PMinhDuc204/pwm-solar-design/kicad/pwm-2420-lus.kicad_pcb

## KiCad design kicad/pwm-2420-lus.kicad_pcb (2026-11-06)

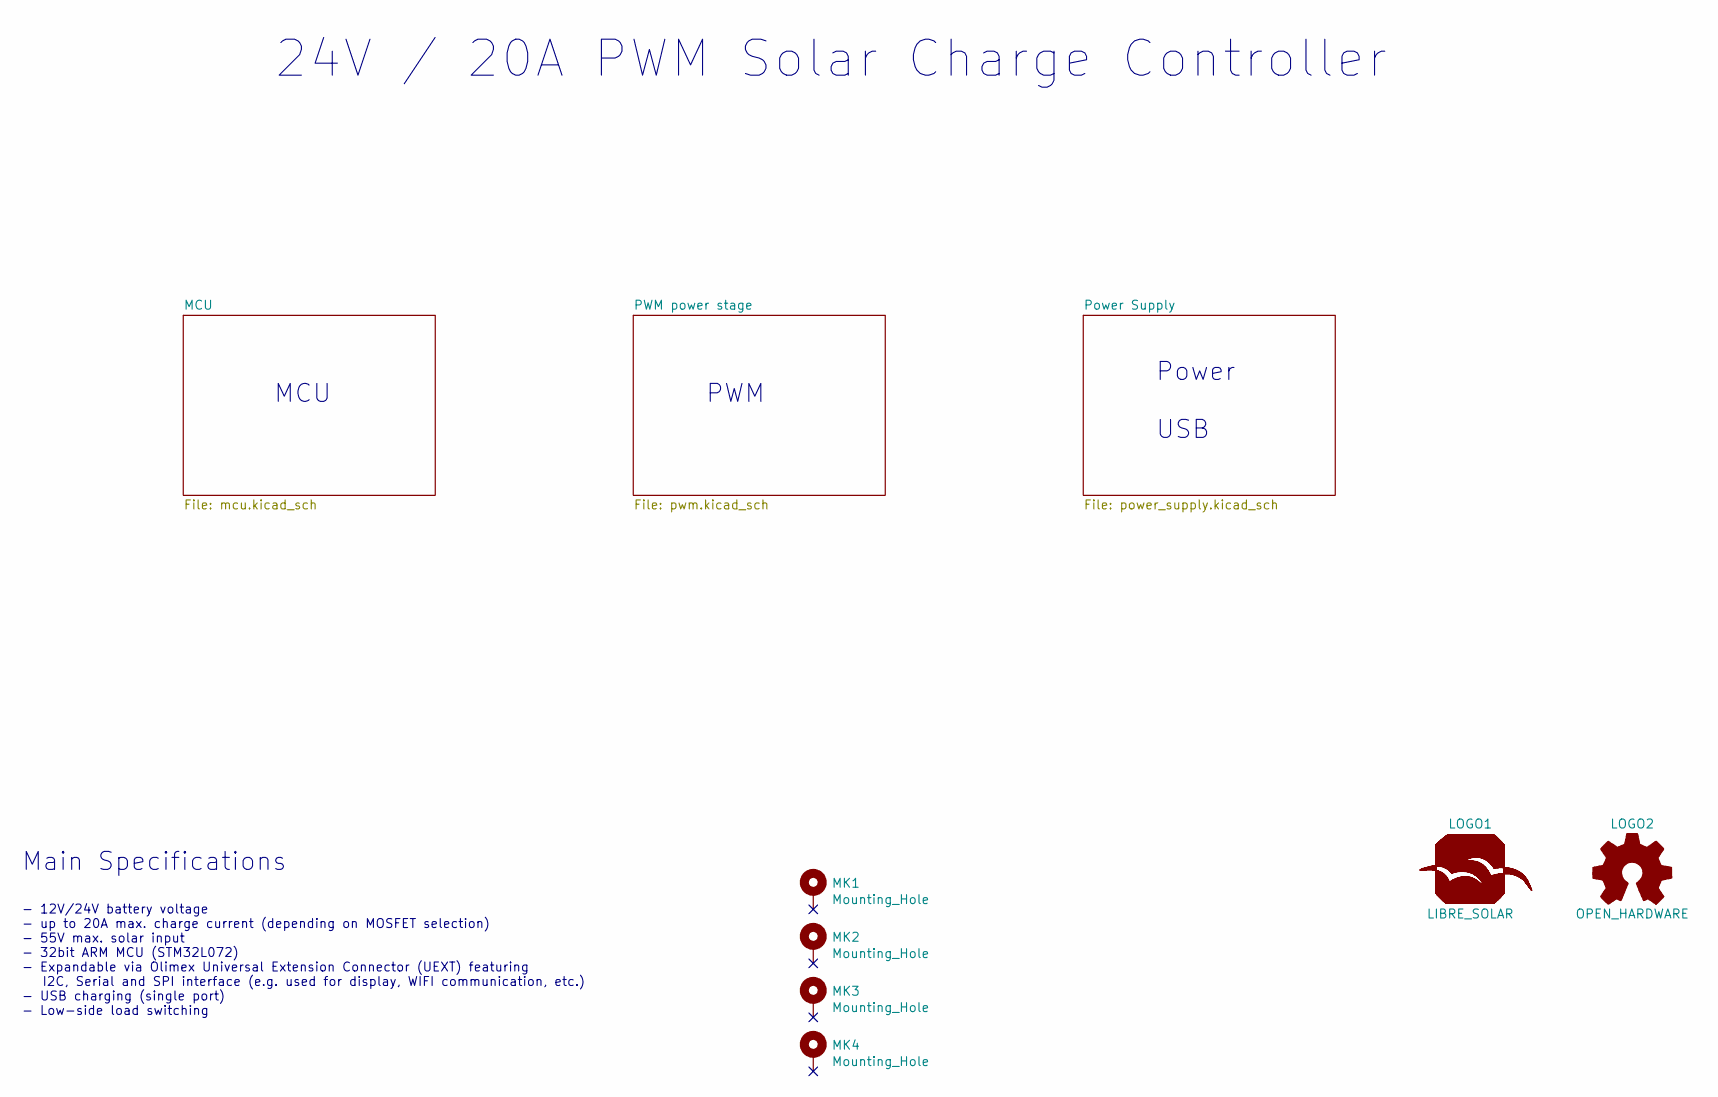
[picture p1: schematic pwm-2420-lus.kicad_sch, PWM 2420 LUS]

Parts:
LOGO1: LIBRE_SOLAR; LIBRESOLAR_LOGO
LOGO2: OPEN_HARDWARE; OSHW-Logo_5.7x6mm_SilkScreen
MK1, MK2, MK3, MK4: Mounting_Hole; MountingHole_3.2mm_M3_Pad

Notes on the sheet:
MCU
Main Specifications
24V / 20A PWM Solar Charge Controller
PWM
- 12V/24V battery voltage - up to 20A max. charge current (depending on MOSFET selection) - 55V max. solar input - 32bit ARM MCU (STM32L072) - Expandable via Olimex Universal Extension Connector (UEXT) featuring I2C, Serial and SPI interface (e.g. used for display, WIFI communication, etc.) - USB c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
Power USB

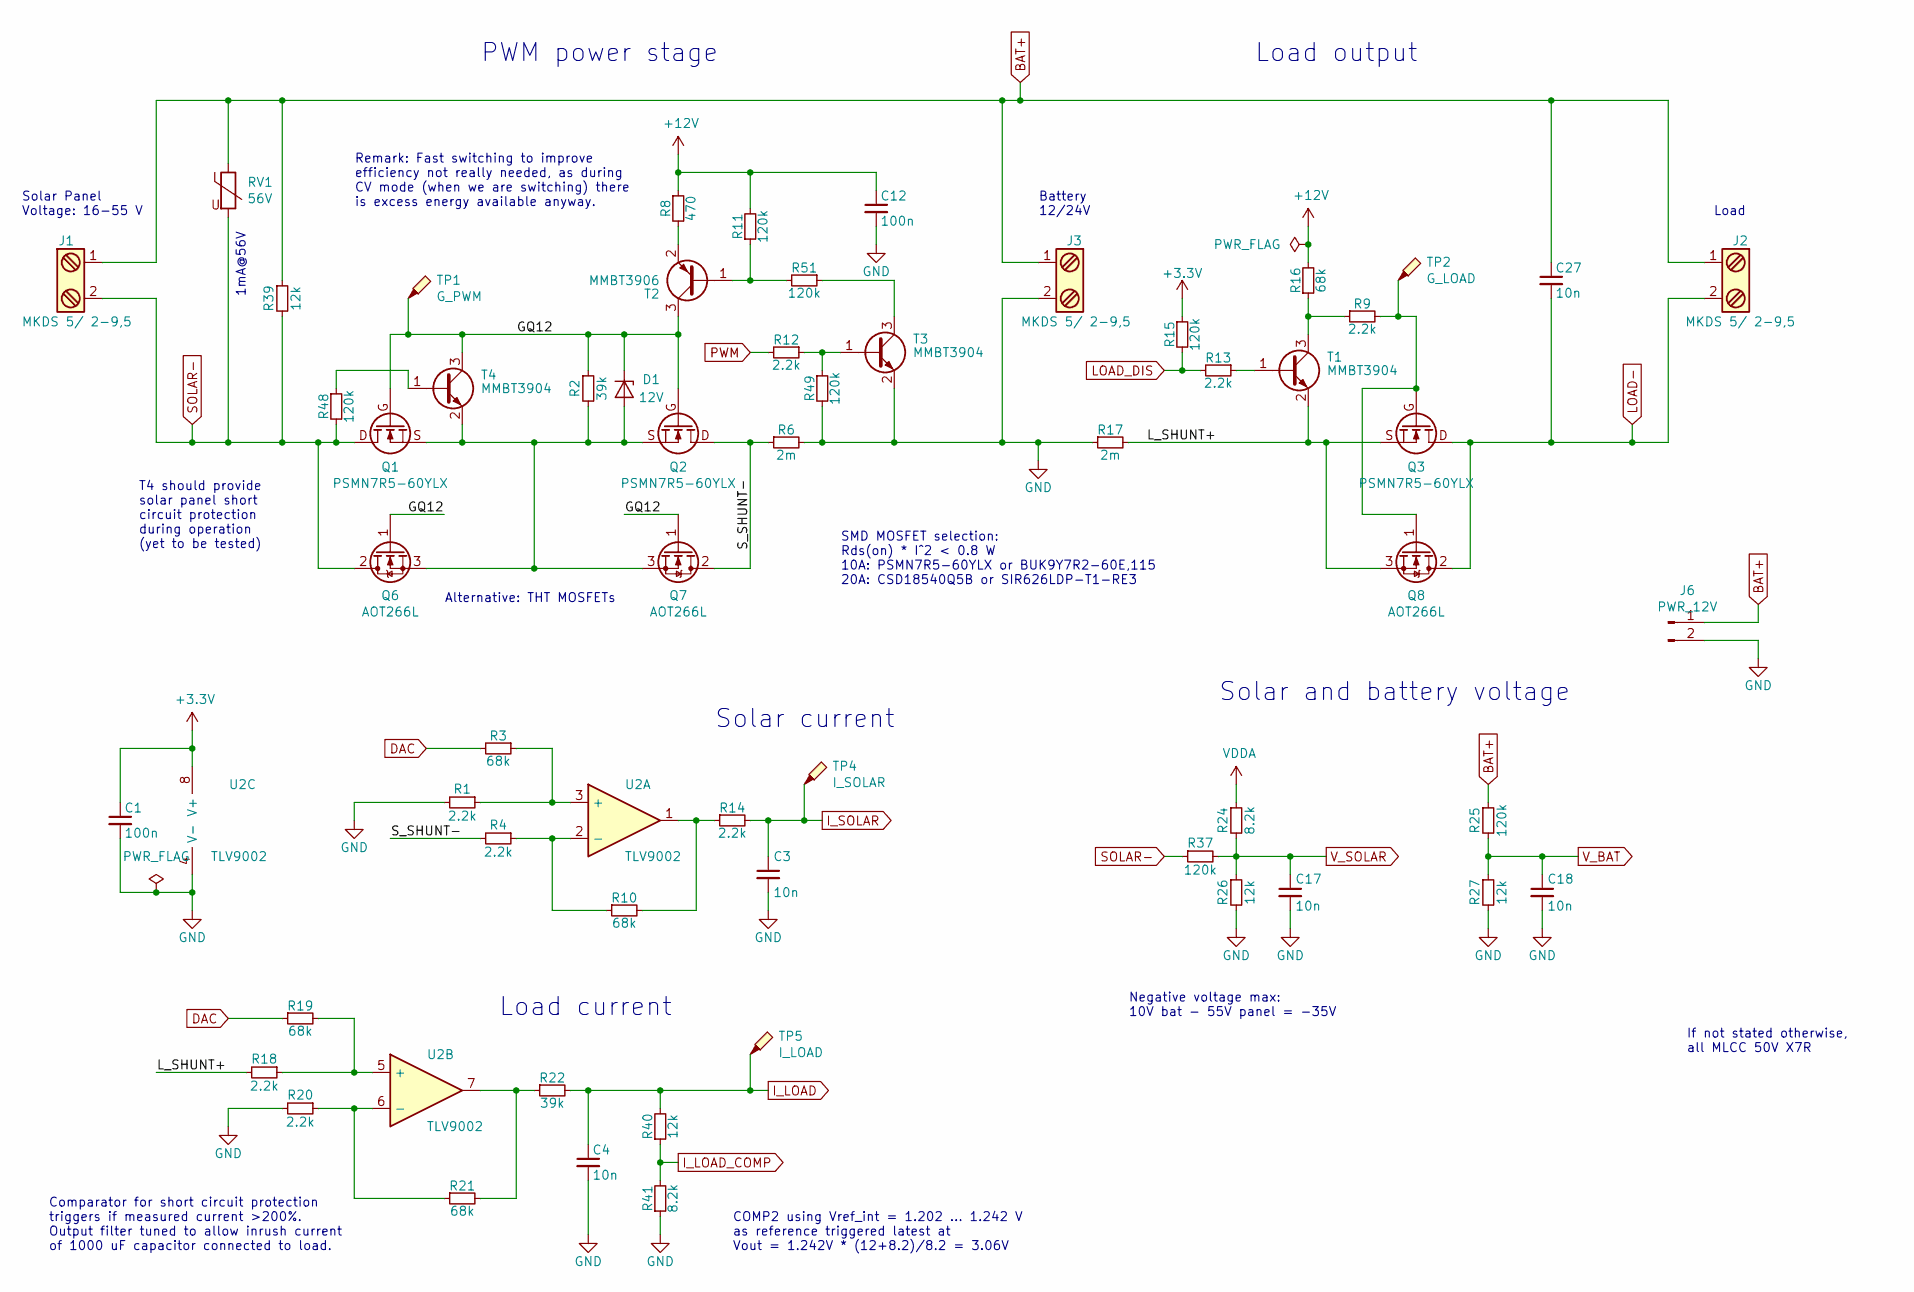
[picture p2: schematic pwm.kicad_sch, PWM 2420 LUS]

Parts:
C1, C12: 100n; C_0805_2012; PartNumber CC0805KRX7R9BB104
C3, C4, C17, C18, C27: 10n; C_0805_2012; PartNumber CC0805KRX7R0BB103
D1: 12V; D_SOT-23_ANK; PartNumber SZBZX84C12LT3G
J1, J2, J3: MKDS 5/ 2-9,5; Phoenix_Contact_MKDS_5-2-952; PartNumber 1714971
J6: PWR_12V; JST_XH_B2B-XH-A_1x02_P2.50mm_Vertical; PartNumber B2B-XH-A (LF)(SN)
Q1, Q2, Q3: PSMN7R5-60YLX; 5X6_MOSFET; PartNumber PSMN7R5-60YLX
Q6, Q7, Q8: AOT266L; TO-220-3_Horizontal_TabUp; PartNumber AOT266L
R1, R4, R9, R12, R13, R14, R18, R20: 2.2k; R_0805_2012; PartNumber RC0805FR-072K2L
R2: 39k; R_0805_2012; PartNumber RC0805FR-0739KL
R3, R10, R16, R19, R21: 68k; R_0805_2012; PartNumber RC0805FR-0768KL
R6, R17: 2m; R_Bourns_CRE2512; PartNumber CRE2512-FZ-R002E-3
R8: 470; R_0805_2012; PartNumber RC0805FR-07470RL
R11, R15, R25, R37, R48, R49, R51: 120k; R_0805_2012; PartNumber RC0805FR-07120KL
R22: 39k; R_0805_2012; PartNumber RC0805FR-0739K0L
R24, R41: 8.2k; R_0805_2012; PartNumber RC0805FR-078K2L
R26, R27, R39, R40: 12k; R_0805_2012; PartNumber RC0805FR-0712KL
RV1: 56V; RV_Disc_D12mm_W4.3mm_P7.5mm; PartNumber MOV-10D560K
T1, T3, T4: MMBT3904; SOT-23; PartNumber MMBT3904-7-F
T2: MMBT3906; SOT-23; PartNumber MMBT3906-7-F
TP1: G_PWM; TestPoint_Pad_D1.0mm
TP2: G_LOAD; TestPoint_Pad_D1.0mm
TP4: I_SOLAR; TestPoint_Pad_D1.0mm
TP5: I_LOAD; TestPoint_Pad_D1.0mm
U2: TLV9002; SOIC-8_3.9x4.9mm_Pitch1.27mm; PartNumber LM258DR

Connections:
+3V3: C1.1, R15.1, U2.8 (V+); also elsewhere on the board
+12V: C12.1, R8.1, R11.2, R16.2; also elsewhere on the board
/PWM power stage/GQ12: D1.1 (K), Q1.G, Q2.G, Q6.1 (G), Q7.1 (G), R2.1, T2.3 (C), T4.3 (C), TP1.1
/PWM power stage/L_SHUNT+: Q3.S, Q8.3 (S), R17.2, R18.2, T1.2 (E)
/PWM power stage/S_SHUNT-: Q2.D, Q7.2 (D), R4.2, R6.1
BAT+: C27.1, J1.1, J2.1, J3.1, J6.1, R25.1, R39.1, RV1.1; also elsewhere on the board
DAC: R3.2, R19.1; also elsewhere on the board
GND: C1.2, C3.2, C4.2, C12.2, C17.2, C18.2, J3.2, J6.2, R1.2, R6.2, R17.1, R20.2, R26.2, R27.2, R41.1, R49.2, T3.2 (E), U2.4 (V-); also elsewhere on the board
I_LOAD: C4.1, R22.2, R40.2, TP5.1; also elsewhere on the board
I_LOAD_COMP: R40.1, R41.2; also elsewhere on the board
I_SOLAR: C3.1, R14.2, TP4.1; also elsewhere on the board
LOAD-: C27.2, J2.2, Q3.D, Q8.2 (D); also elsewhere on the board
LOAD_DIS: R13.2, R15.2; also elsewhere on the board
unnamed: D1.2 (A), Q1.S, Q2.S, Q6.3 (S), Q7.3 (S), R2.2, T4.2 (E)
unnamed: Q3.G, Q8.1 (G), R9.2, TP2.1
unnamed: R1.1, R3.1, U2.3 (+)
unnamed: R8.2, T2.2 (E)
unnamed: R4.1, R10.1, U2.2 (-)
unnamed: R10.2, R14.1, U2.1
unnamed: R11.1, R51.2, T2.1 (B)
unnamed: R12.1, R49.1, T3.1 (B)
unnamed: R13.1, T1.1 (B)
unnamed: R9.1, R16.1, T1.3 (C)
unnamed: R18.1, R19.2, U2.5 (+)
unnamed: R20.1, R21.1, U2.6 (-)
unnamed: R21.2, R22.1, U2.7
unnamed: R48.1, T4.1 (B)
unnamed: R51.1, T3.3 (C)
PWM: R12.2; also elsewhere on the board
SOLAR-: J1.2, Q1.D, Q6.2 (D), R37.1, R39.2, R48.2, RV1.2
VDDA: R24.1; also elsewhere on the board
V_BAT: C18.1, R25.2, R27.1; also elsewhere on the board
V_SOLAR: C17.1, R24.2, R26.1, R37.2; also elsewhere on the board

Notes on the sheet:
Solar current
Comparator for short circuit protection triggers if measured current >200%. Output filter tuned to allow inrush current of 1000 uF capacitor connected to load.
Solar and battery voltage
Load current
Load
Remark: Fast switching to improve efficiency not really needed, as during CV mode (when we are switching) there is excess energy available anyway.
SMD MOSFET selection: Rds(on) * I^2 < 0.8 W 10A: PSMN7R5-60YLX or BUK9Y7R2-60E,115 20A: CSD18540Q5B or SIR626LDP-T1-RE3
Battery 12/24V
Load output
Solar Panel Voltage: 16-55 V
1mA@56V
PWM power stage
Negative voltage max: 10V bat - 55V panel = -35V
COMP2 using Vref_int = 1.202 ... 1.242 V as reference triggered latest at Vout = 1.242V * (12+8.2)/8.2 = 3.06V
T4 should provide solar panel short circuit protection during operation (yet to be tested)
If not stated otherwise, all MLCC 50V X7R
Alternative: THT MOSFETs

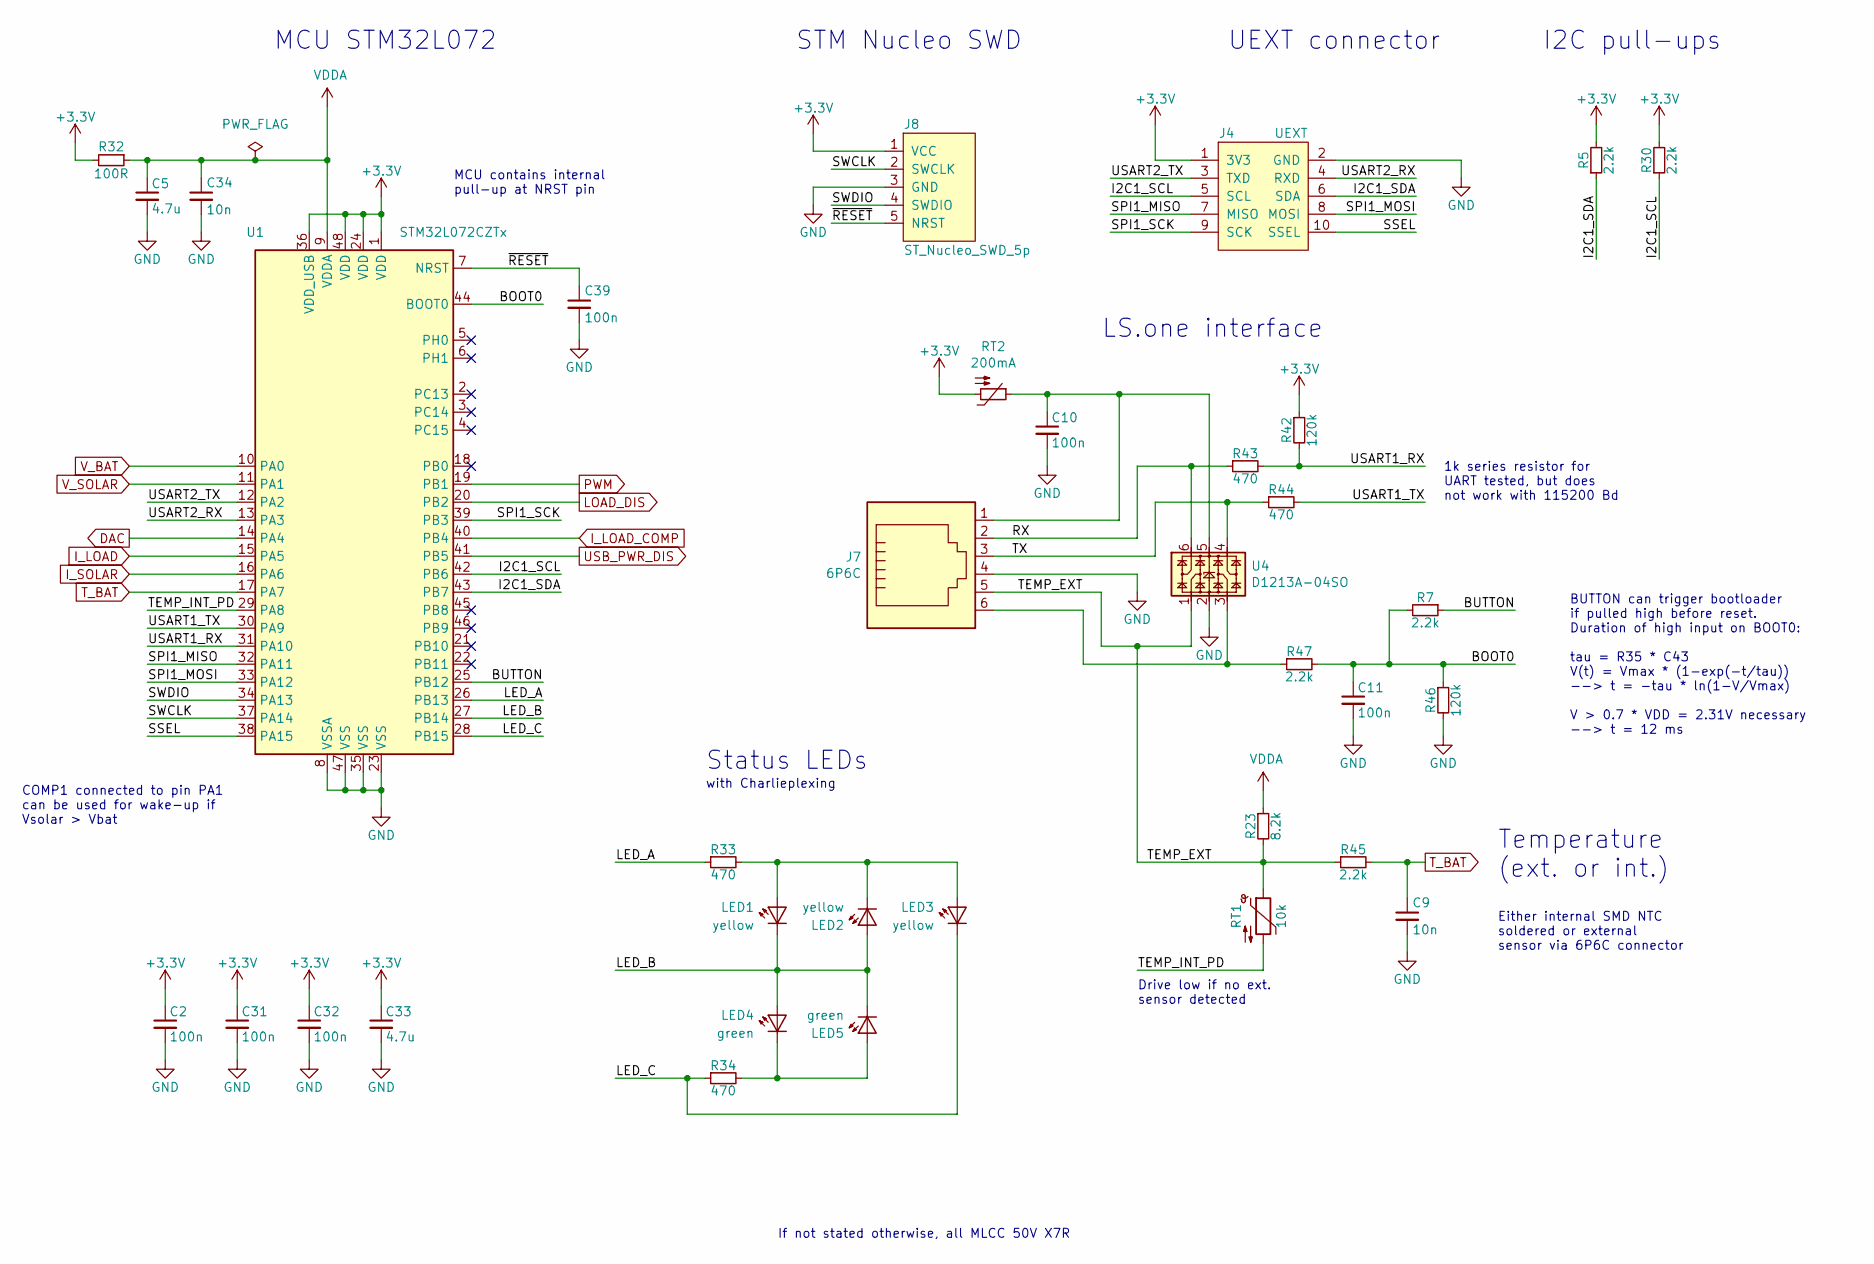
[picture p3: schematic mcu.kicad_sch, PWM 2420 LUS]

Parts:
C2, C10, C11, C31, C32, C39: 100n; C_0805_2012; PartNumber CC0805KRX7R9BB104
C5, C33: 4.7u; C_0805_2012; PartNumber 885012107018
C9, C34: 10n; C_0805_2012; PartNumber CC0805KRX7R0BB103
J4: UEXT; Box_Header_2x05x2.54mm_Straight; PartNumber 302-S101
J7: 6P6C; RJ25_6P6C_TabUp; PartNumber 615006138421
J8: ST_Nucleo_SWD_5p; PinHeader_1x05_P2.54mm_Vertical
LED1, LED2, LED3: yellow; LED_0603_D3.0mm; PartNumber LTL-1CHY
LED4, LED5: green; LED_0603_D3.0mm; PartNumber LTL-4231
R5, R7, R30, R45, R47: 2.2k; R_0805_2012; PartNumber RC0805FR-072K2L
R23: 8.2k; R_0805_2012; PartNumber RC0805FR-078K2L
R32: 100R; R_0805_2012; PartNumber RC0805FR-07100RL
R33, R34, R43, R44: 470; R_0805_2012; PartNumber RC0805FR-07470RL
R42, R46: 120k; R_0805_2012; PartNumber RC0805FR-07120KL
RT1: 10k; R_0805_2012; PartNumber NCP21XV103J03RA
RT2: 200mA; R_1206_3216; PartNumber 0ZCJ0020FF2E
U1: STM32L072CZTx; LQFP-48_7x7mm_P0.5mm; PartNumber STM32L072CZT6
U4: D1213A-04SO; SOT-23-6; PartNumber D1213A-04SO

Connections:
+3V3: C2.1, C31.1, C32.1, C33.1, J4.1 (3V3), J8.1 (VCC), R5.2, R30.2, R32.2, R42.1, RT2.2, U1.1 (VDD), U1.24 (VDD), U1.36 (VDD_USB), U1.48 (VDD); also elsewhere on the board
/MCU/BOOT0: C11.1, R7.2, R46.1, R47.2, U1.44 (BOOT0)
/MCU/BUTTON: R7.1, U1.25 (PB12)
/MCU/I2C1_SCL: J4.5 (SCL), R30.1, U1.42 (PB6)
/MCU/I2C1_SDA: J4.6 (SDA), R5.1, U1.43 (PB7)
/MCU/LED_A: R33.1, U1.26 (PB13)
/MCU/LED_B: LED1.1 (K), LED2.2 (A), LED4.2 (A), LED5.1 (K), U1.27 (PB14)
/MCU/LED_C: LED3.1 (K), R34.1, U1.28 (PB15)
/MCU/RX: J7.2, R43.1, U4.6
/MCU/SPI1_MISO: J4.7 (MISO), U1.32 (PA11)
/MCU/SPI1_MOSI: J4.8 (MOSI), U1.33 (PA12)
/MCU/SPI1_SCK: J4.9 (SCK), U1.39 (PB3)
/MCU/SSEL: J4.10 (SSEL), U1.38 (PA15)
/MCU/SWCLK: J8.2 (SWCLK), U1.37 (PA14)
/MCU/SWDIO: J8.4 (SWDIO), U1.34 (PA13)
/MCU/TEMP_EXT: J7.5, R23.2, R45.1, RT1.1, U4.1
/MCU/TEMP_INT_PD: RT1.2, U1.29 (PA8)
/MCU/TX: J7.3, R44.1, U4.4
/MCU/USART1_RX: R42.2, R43.2, U1.31 (PA10)
/MCU/USART1_TX: R44.2, U1.30 (PA9)
/MCU/USART2_RX: J4.4 (RXD), U1.13 (PA3)
/MCU/USART2_TX: J4.3 (TXD), U1.12 (PA2)
/MCU/~RESET: C39.1, J8.5 (NRST), U1.7 (NRST)
DAC: U1.14 (PA4); also elsewhere on the board
GND: C2.2, C5.2, C9.2, C10.2, C11.2, C31.2, C32.2, C33.2, C34.2, C39.2, J4.2 (GND), J7.4, J8.3 (GND), R46.2, U1.8 (VSSA), U1.23 (VSS), U1.35 (VSS), U1.47 (VSS), U4.2; also elsewhere on the board
I_LOAD: U1.15 (PA5); also elsewhere on the board
I_LOAD_COMP: U1.40 (PB4); also elsewhere on the board
I_SOLAR: U1.16 (PA6); also elsewhere on the board
LOAD_DIS: U1.20 (PB2); also elsewhere on the board
unnamed: C10.1, J7.1, RT2.1, U4.5
unnamed: J7.6, R47.1, U4.3
unnamed: LED1.2 (A), LED2.1 (K), LED3.2 (A), R33.2
unnamed: LED4.1 (K), LED5.2 (A), R34.2
PWM: U1.19 (PB1); also elsewhere on the board
T_BAT: C9.1, R45.2, U1.17 (PA7)
USB_PWR_DIS: U1.41 (PB5); also elsewhere on the board
VDDA: C5.1, C34.1, R23.1, R32.1, U1.9 (VDDA); also elsewhere on the board
V_BAT: U1.10 (PA0); also elsewhere on the board
V_SOLAR: U1.11 (PA1); also elsewhere on the board

Notes on the sheet:
MCU STM32L072
COMP1 connected to pin PA1 can be used for wake-up if Vsolar > Vbat
LS.one interface
Drive low if no ext. sensor detected
Temperature (ext. or int.)
with Charlieplexing
BUTTON can trigger bootloader if pulled high before reset. Duration of high input on BOOT0: tau = R35 * C43 V(t) = Vmax * (1-exp(-t/tau)) --> t = -tau * ln(1-V/Vmax) V > 0.7 * VDD = 2.31V necessary --> t = 12 ms
UEXT connector
MCU contains internal pull-up at NRST pin
Status LEDs
I2C pull-ups
1k series resistor for UART tested, but does not work with 115200 Bd
STM Nucleo SWD
Either internal SMD NTC soldered or external sensor via 6P6C connector
If not stated otherwise, all MLCC 50V X7R

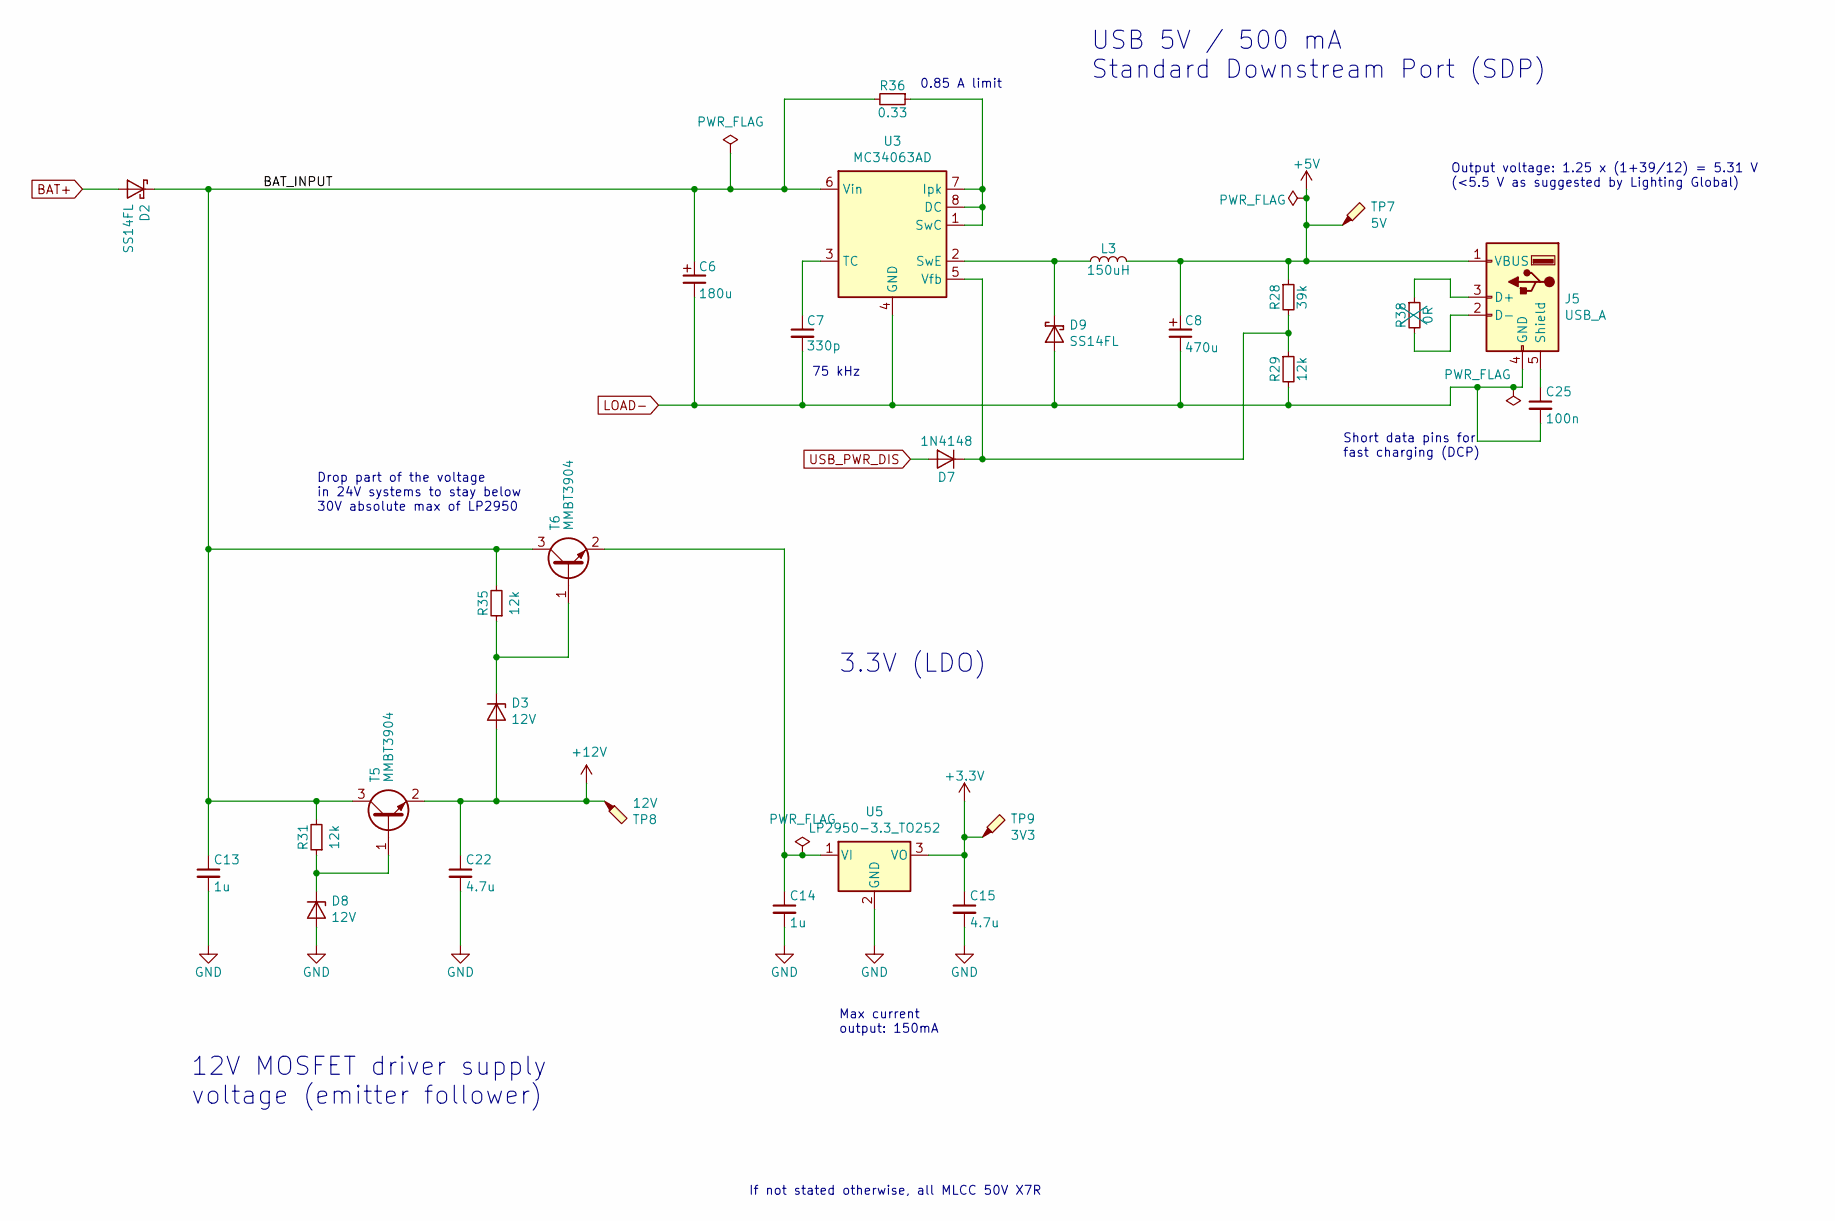
[picture p4: schematic power_supply.kicad_sch, PWM 2420 LUS]

Parts:
C6: 180u; CP_Radial_D8.0mm_P3.50mm; PartNumber EEU-FR1V181
C7: 330p; C_0805_2012; PartNumber 885342007002
C8: 470u; CP_Radial_D8.0mm_P3.50mm; PartNumber EEUFR1A471
C13, C14: 1u; C_0805_2012; PartNumber CC0805KKX7R9BB105
C15, C22: 4.7u; C_0805_2012; PartNumber 885012107018
C25: 100n; C_0805_2012; PartNumber CC0805KRX7R9BB104
D2, D9: SS14FL; D_SOD-123F; PartNumber SS14FL
D3, D8: 12V; D_SOT-23_ANK; PartNumber SZBZX84C12LT3G
D7: 1N4148; D_SOD-123; PartNumber 1N4148W-7-F
J5: USB_A; USB_A_Wuerth_61400416021_Horizontal; PartNumber 61400416021
L3: 150uH; L_Radial_D12.0mm_P5.00mm_Fastron_11P; PartNumber RLB0914-151KL
R28: 39k; R_0805_2012; PartNumber RC0805FR-0739KL
R29, R31, R35: 12k; R_0805_2012; PartNumber RC0805FR-0712KL
R36: 0.33; R_1206_3216; PartNumber RL1206FR-070R33L
R38: 0R; R_0805_2012; PartNumber RC0805FR-070RL
T5, T6: MMBT3904; SOT-23; PartNumber MMBT3904-7-F
TP7: 5V; TestPoint_Pad_D1.0mm
TP8: 12V; TestPoint_Pad_D1.0mm
TP9: 3V3; TestPoint_Pad_D1.0mm
U3: MC34063AD; SOIC-8_3.9x4.9mm_P1.27mm; PartNumber MC34063ADR
U5: LP2950-3.3_TO252; TO-252-2; PartNumber LP2950ACDT-3.3RG

Connections:
+3V3: C15.1, TP9.1, U5.3 (VO); also elsewhere on the board
+5V: C8.1, J5.1 (VBUS), L3.2, R28.1, TP7.1
+12V: C22.1, D3.2 (A), T5.2 (E), TP8.1; also elsewhere on the board
/Power Supply/BAT_INPUT: C6.1, C13.1, D2.1 (K), R31.2, R35.2, R36.2, T5.3 (C), T6.3 (C), U3.6 (Vin)
BAT+: D2.2 (A); also elsewhere on the board
GND: C13.2, C14.2, C15.2, C22.2, D8.2 (A), U5.2 (GND); also elsewhere on the board
LOAD-: C6.2, C7.2, C8.2, C25.2, D9.2 (A), J5.4 (GND), R29.2, U3.4 (GND); also elsewhere on the board
unnamed: C7.1, U3.3 (TC)
unnamed: C14.1, T6.2 (E), U5.1 (VI)
unnamed: C25.1, J5.5 (Shield)
unnamed: D3.1 (K), R35.1, T6.1 (B)
unnamed: D7.1 (K), R28.2, R29.1, U3.5 (Vfb)
unnamed: D8.1 (K), R31.1, T5.1 (B)
unnamed: D9.1 (K), L3.1, U3.2 (SwE)
unnamed: J5.2 (D-), R38.2
unnamed: J5.3 (D+), R38.1
unnamed: R36.1, U3.1 (SwC), U3.7 (Ipk), U3.8 (DC)
USB_PWR_DIS: D7.2 (A); also elsewhere on the board

Notes on the sheet:
0.85 A limit
Max current output: 150mA
USB 5V / 500 mA Standard Downstream Port (SDP)
Drop part of the voltage in 24V systems to stay below 30V absolute max of LP2950
3.3V (LDO)
12V MOSFET driver supply voltage (emitter follower)
If not stated otherwise, all MLCC 50V X7R
Short data pins for fast charging (DCP)
75 kHz
Output voltage: 1.25 x (1+39/12) = 5.31 V (<5.5 V as suggested by Lighting Global)

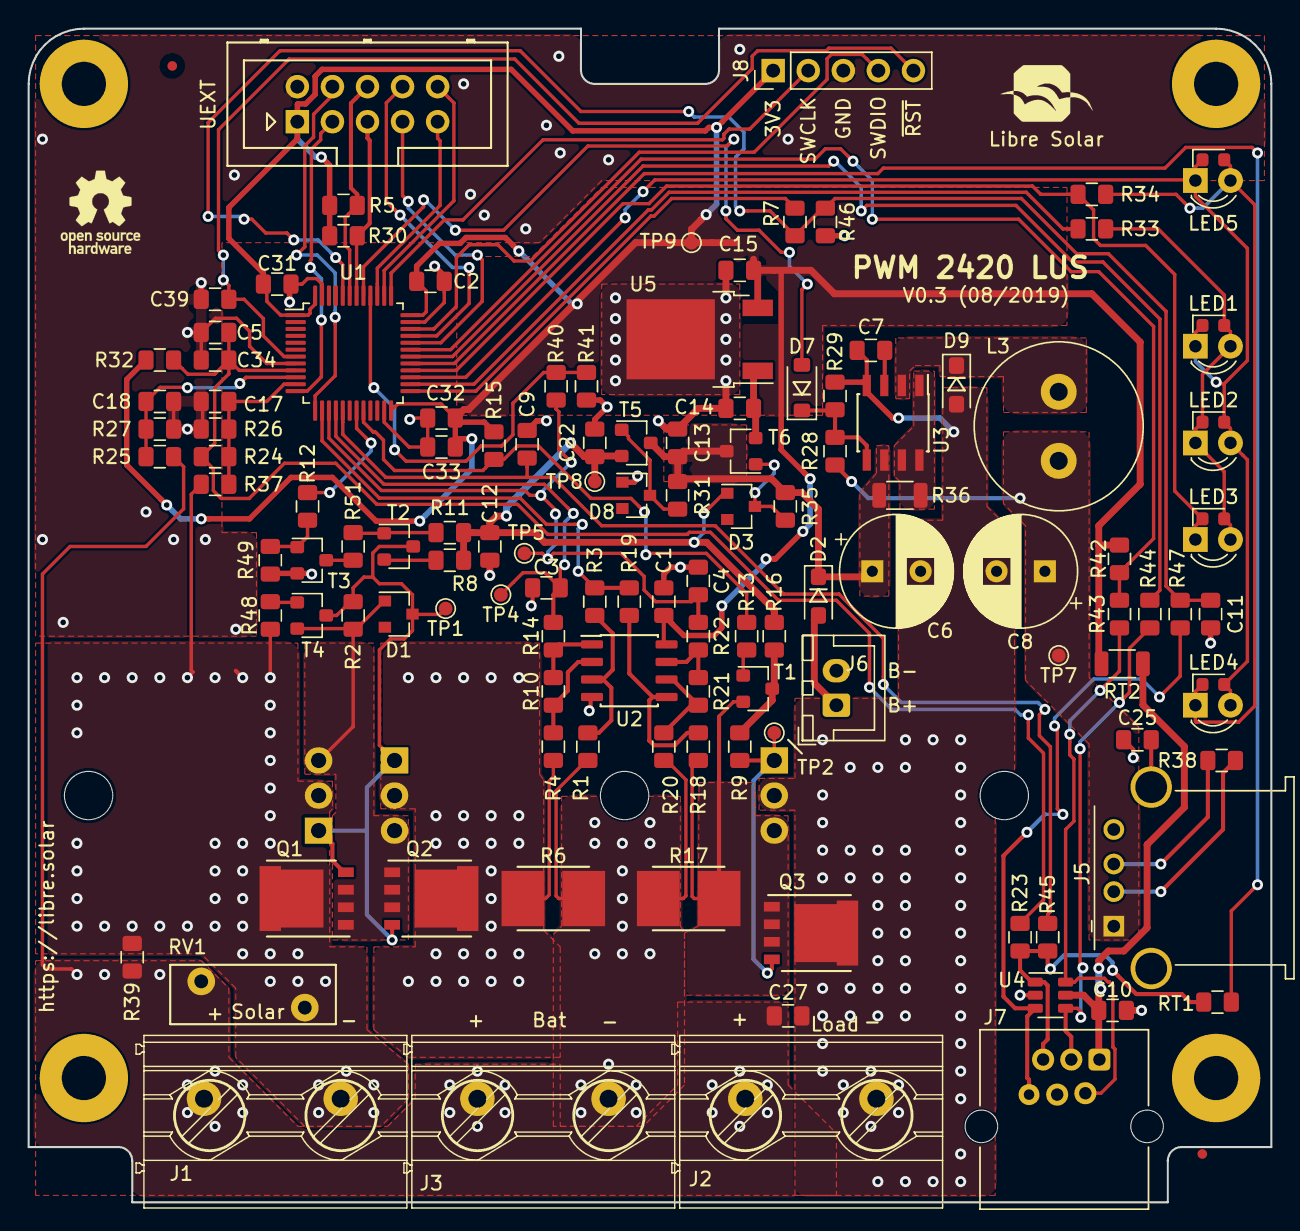
[picture p5: board pwm-2420-lus.kicad_pcb from above]

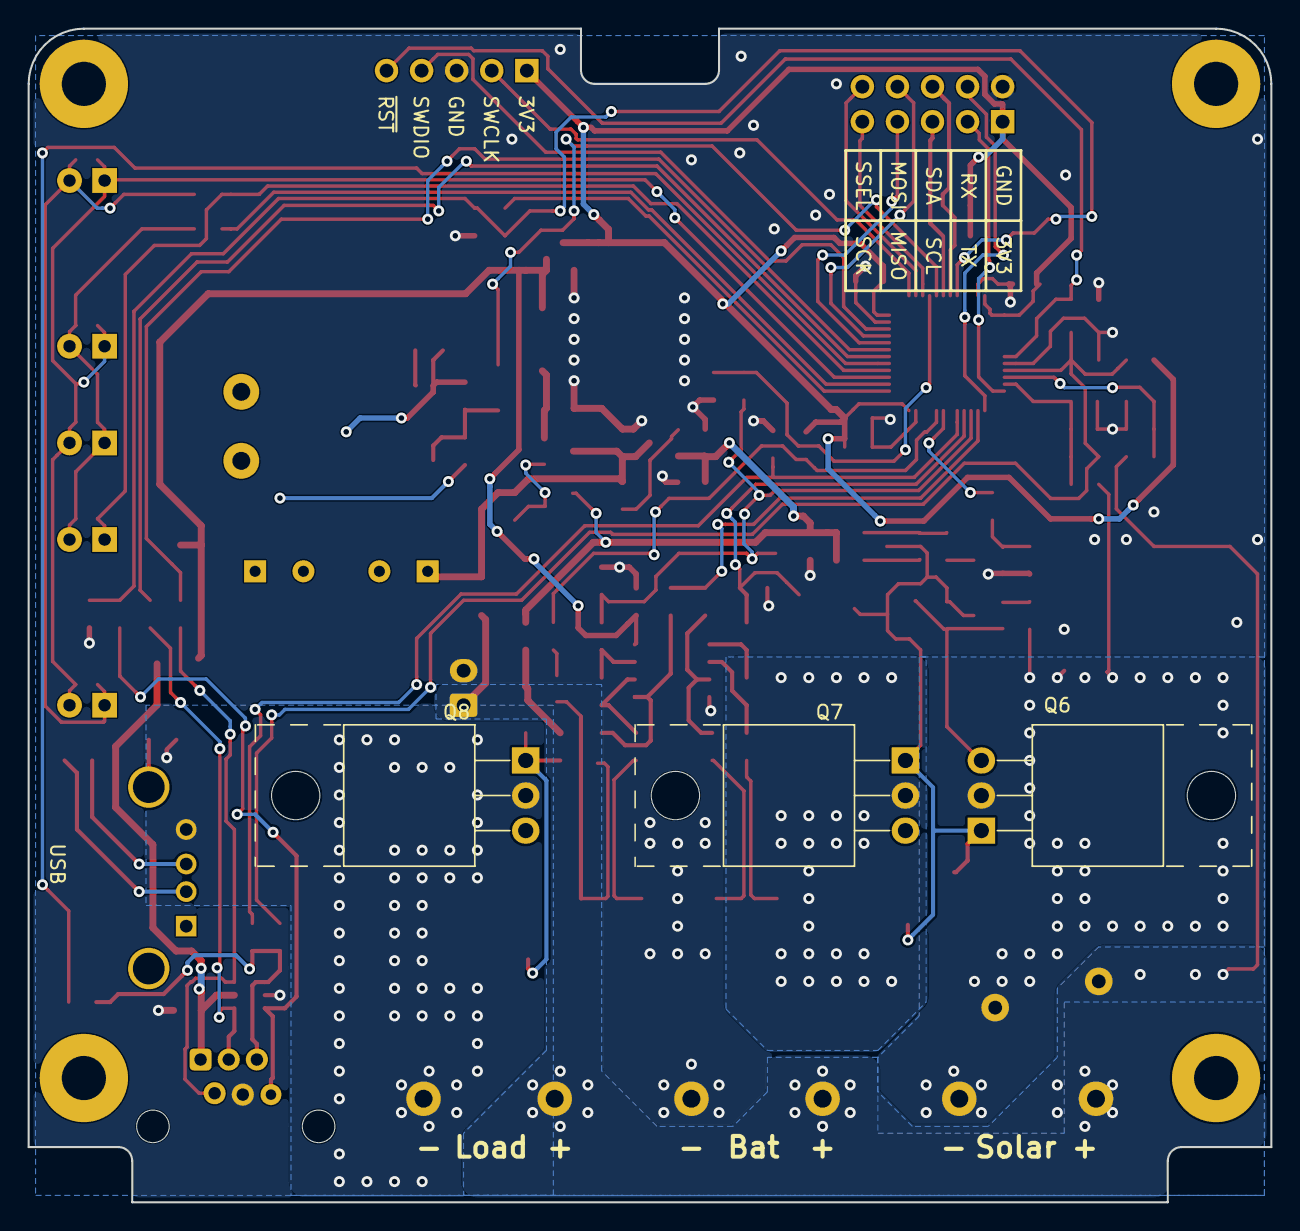
[picture p6: board pwm-2420-lus.kicad_pcb from below]

Board: 2 copper layers, 90.0 x 85.0 mm, 128 parts (3 on the bottom side), 73 nets.
